JierunCHEN/Implement-a-Photovoltaic-Power-Tracker-Prototype/README.md

# Implement-a-Photovoltaic-Power-Tracker-Prototype
This is a project selected from the Electronic Product Design Contest in Jiangsu province in 2013. The repository includes both hardware and software guides. Make it and have fun!
