JierunCHEN/Implement-a-Photovoltaic-Power-Tracker-Prototype/hardware_docs/Soldering_Guide/物件清单.pdf

名称 | 型号规格 | 数量
Description | Comment | Quantity
模拟光伏追踪系统执 行机构（已安装） | 包括塑料实验箱，DCP-12-1,DCP-12-2,DCP-12-3，塑料支架等 | 1
铝围机箱 | 260*150*290 | 1
前面板（酚荃板） | DCP-12 | 1
后面板（酚荃板） | DCP-12-2 | 1
底板（酚荃板） | DCP-12-3 | 1
船形开关 | | 1
七芯航空插座（圆） | XS12P | 1
四芯航空插座（圆） | XS12J4A | 1
接线端子（座） | SH242-5.08-4P | 1
接线端子（头） | SH241-5.08-2P | 2
接线端子（座） | SH242-5.08-2P | 2
彩色杜邦线（两头孔） 50cm | | 4
二号导线 | 100CM 红 | 8
二号导线 | 30CM 黑 | 8
二号导线 | 100CM 绿 | 2
二号导线 | 50CM 蓝 | 6
12P扁平带连接线 | 50cm | 7
船形开关插簧 | φ4.8 | 4
船形开关插簧套 | | 4
铜柱子 | M5x10+M3 | 5
铜柱子 | M5x35+M3 | 10
自攻螺丝 | 带垫M3x8 | 5
沉头螺丝 | M3x8 | 5
十字螺丝 | M3x12 | 15
面板螺丝 | M3x6 | 15
螺母 | M3 | 20
平垫 | M3 | 20
弹垫 | M3 | 20
线号号码管 | +12V | 15
线号号码管 | GND | 15
线号号码管 | V1 | 3
线号号码管 | V2 | 3

线号号码管 | V3 | 3
线号号码管 | V4 | 3
线号号码管 | V5 | 3
线号号码管 | OUT1 | 3
线号号码管 | OUT2 | 3
线号号码管 | MOTOR+ | 3
线号号码管 | MOTOR- | 3
热缩管 | φ4 | 40CM
绑扎带 | | 20
黄腊管 | φ2.5 | 50CM
连接线1（已做好） | 4P接线端子*2+80CM线 | 1
连接线2（已做好） | 七芯头+80CM线+6P接线头 1
连接线3（已做好） | 四芯头+80CM线+4P接线头 1
模拟太阳能板焊接套件另见设计元器件清单 | | 1
H桥PWM输出电路焊接套件另见DCP-218-A元器件清单 1
