JierunCHEN/Implement-a-Photovoltaic-Power-Tracker-Prototype/hardware_docs/Soldering_Guide/设计元器件清单.pdf

名称 | 型号规格 | 封装 | 数量
Description | Comment | Footprint Quantity
线路板 | DCP-12-4 V1.0.PCB | | 1
单圈电位器 | WH5-1A 2.2K | | 1
单圈电位器 | WH5-1A 1K | | 1
单圈电位器 | WH5-1A 470 | | 1
3296可调电位器2K | | 3296W | 1
3296可调电位器5K | | 3296W | 2
3296可调电位器200欧姆 | | 3296W | 1
贴片电容 | 0.1uF | 0805C | 2
贴片电容 | 0.01uF | 0805R | 2
贴片电阻 | 200欧姆 | 0805R | 5
贴片电阻 | 330欧姆 | 0805R | 5
贴片电阻 | 510欧姆 | 0805R | 5
贴片电阻 | 1K | 0805R | 5
贴片电阻 | 2K | 0805R | 5
贴片电阻 | 3.3K | 0805R | 5
贴片电阻 | 5.1K | 0805R | 5
贴片电阻 | 10K | 0805R | 5
贴片电阻 | 12K | 0805R | 5
贴片电阻 | 15K | 0805R | 5
贴片电阻 | 18K | 0805R | 5
贴片电阻 | 20K | 0805R | 5
贴片电阻 | 22K | 0805R | 5
贴片电阻 | 27K | 0805R | 5
贴片电阻 | 0欧姆 | 0805R | 5
贴片芯片 | LM358 | SOIC8 | 1
接线插座（直） XH2.54-4P | | HDR1*4 | 1
