JierunCHEN/Implement-a-Photovoltaic-Power-Tracker-Prototype/(list of files, cad)

Other CAD files:
Debug/sor/Internal_ADC.obj
Debug/sor/ADS1118A.obj
Debug/sor/key_event.obj
Debug/sor/clock.obj
Debug/sor/Motor.obj
Debug/sor/cry12864.obj
