JierunCHEN/Implement-a-Photovoltaic-Power-Tracker-Prototype/project_log_JierunCHEN.txt

2016/7/16
1.	下载FTP上软件包，安装CCS5.1屡战屡败，于是尝试安装CCS5.4版本，同样安装未果，因为班上大部分人安装5.4版本都成功了，所以应该是我机子或电脑设置存在问题。
2.	寻求度娘帮助，尝试了几种办法，关闭杀毒软件，清理注册表重装，安装路径设为全英文，然而都没有效果。
3.	于是注册了Ti论坛账号寻求帮助，得到好心人指点，原因在于电脑账户名应改为英文
4.	我尝试在不建立新账户名的情况下安装软件，CCS软件可以用了，但其他程序出现问题了。于是只好乖乖建立一个新的英文账户，同时应注意workspace路径不能出现中文。

2016/7/17
1.	观看ccs使用教学视频，学会项目建立，源文件和头文件建立，编译和调试等基本操作。
2.	测试学习MSP4300G2553开发板和Lauchpad口袋实验平台例程。学会开发板上LED灯的亮灭和亮度控制，机械按键和触摸开关的使用。

2016/7/18
1:40pm-5:00pm	
1.	学习MSP430单片机的基础操作，如位操作、寄存器的配置方法、中断的使用等；
2.	测试学习MSP4300G2553开发板和Lauchpad口袋实验平台例程

2016/7/19
2：00pm-4:20PM   
翻看Lauchpad口袋实验平台学习资料中的系统时钟、GPIO和TIMEER_A定时器三部分。
7：30pm-11：00pm 
对应实物查看光伏发电跟踪器各模块原理图，和队友探讨分析各部分作用和工作原理。

2016/7/20
8：40am-11：50am
编写光伏发电跟踪器的结构原理解析文档，对整个系统的功能、结构和原理进行综述，再对各模块进行分解剖析。
7：00pm-8：00pm 
检查光伏发电跟踪器硬件是否完好，除接线断裂之外，其他模块可以正常使用。
9：00pm-11：00pm
查看MSP430F5438A定时器设置和PWM波生成方法，掌握定时器初始化函数、周期设定函数和占空比设定函数，确定适合本项目的模式，如增计数模式，OUTMODE为模式7。

2016/7/21
1.	编写PWM波生成文件，观察电机转速及方向，找到合适的周期和占空比。
2.	查看MSP430F5438A使用手册中的内置ADC模块，明白各个控制寄存器和存储寄存器的使用方法，并选择合适的模式（看了十多页的英文文档感觉自己的英语水平提高了呢）。
3.	尝试使用Grace方法编写ADC模块文件，可惜最终悲伤地发现MSP430F5438A不支持Grace插件。

2016/7/22
9：40am-10：30pm
1.	选择MSP430内置12位ADC转换模块编写程序，对照MSP430使用手册，逐一确定ADC控制寄存器的状态，例如设置采样源、设置采样保持时间、选择参考电压源、设置采样顺序及节点、选择多通道单步模式等，最终编完的程序虽然仅有十几行，但却费了我好几个小时。
2.	查看ASD1118用户手册，根据例程改造AD转换程序，选择双通道差模模式。
3.	调节光电检测模块的四个电位器，校准V1、V2和V4、V5电压。
4.	将电机驱动程序和光电检测程序配合，查看效果，能实现正反转，但位置存在一定偏差，初步原因是电机的惯性作用，初步解决方法是变速控制电机。

2016/7/23
1.	搭建总程序框架，完成模式选择、按键设置、采样值转化、启动和停止功能，尚未调试。
2.	还差0.1s定时中断编写。

2016/7/24
11：00am-10：20pm
1.	编写100ms定时中断程序，完成发电模式和跟踪模式的计时，同时每中断一次，更新显示屏上的发电功率和发电量。
2.	编译程序，消除出现的简单错误，如变量重复定义，中英文字符错用。
3.	调试程序，发现出现三个bug，倒计时出现乱码，发电模式下多显示了跟踪模式几个字，发电功率和发电量出现错误。
4.	dedug后发现，上述三bug的原因分别是是倒计时中记录时间的标志位被提前更改，跟踪模式写入地址有误且需要在切换模式时清屏，将发电功率逐位显示有误。
5.	继续调试打怪，发现发电总量一旦超过10000WS,程序就跑飞，原因是此时程序中给一个16位int局部变量beishu赋值100000，该变量溢出。
6.	在相继解决了其他大大小小的问题后，最终开环下系统运行正常，尚未发现其他问题。
7.	初步规划PID控制方法，根据临界比例度法更改程序（在备份开环系统程序后），开辟一个足够大的数组用于存储光电检测数据（数组长度过大程序会跑飞）。
8.	焊接光电检测模块断掉的线。

2016/7/25
8：40am-01：20pm
1.	编写程序，以0.1s为间隔记录开环控制下被控变量光伏检测通道差值ΔU，导出数据并绘制成曲线图，根据临界振荡方法确定PID控制的参数。
2.	根据临界振荡方法确定的PID控制方程更改程序，再次以0.1s为间隔记录开环控制下被控变量光伏检测通道差值ΔU，导出数据绘制曲线图，结合肉眼观察并分析曲线发现，此时虽然电机振荡衰减速度很快，但首次振荡过调幅度很大，综合考虑后决定去除积分环节。
3.	去除积分环节后，发现电机转动过调幅度明显减小，但速度过慢，于是我们结合电机全速运转和PD调节，让电机最初速度加快，当被控变量接近目标值再加入PD调节。
在电机速度既快、过调量也较小的情况下，反复调节比例系数、微分系数、PD控制阀门和光伏检测通道差值ΔU误差容限，使得控制电机不出现振荡或振荡幅度很小且衰减速度很快。
