JierunCHEN/Implement-a-Photovoltaic-Power-Tracker-Prototype/hardware_docs/Soldering_Guide/DCP-218-A H桥PWM输出电路 .pdf

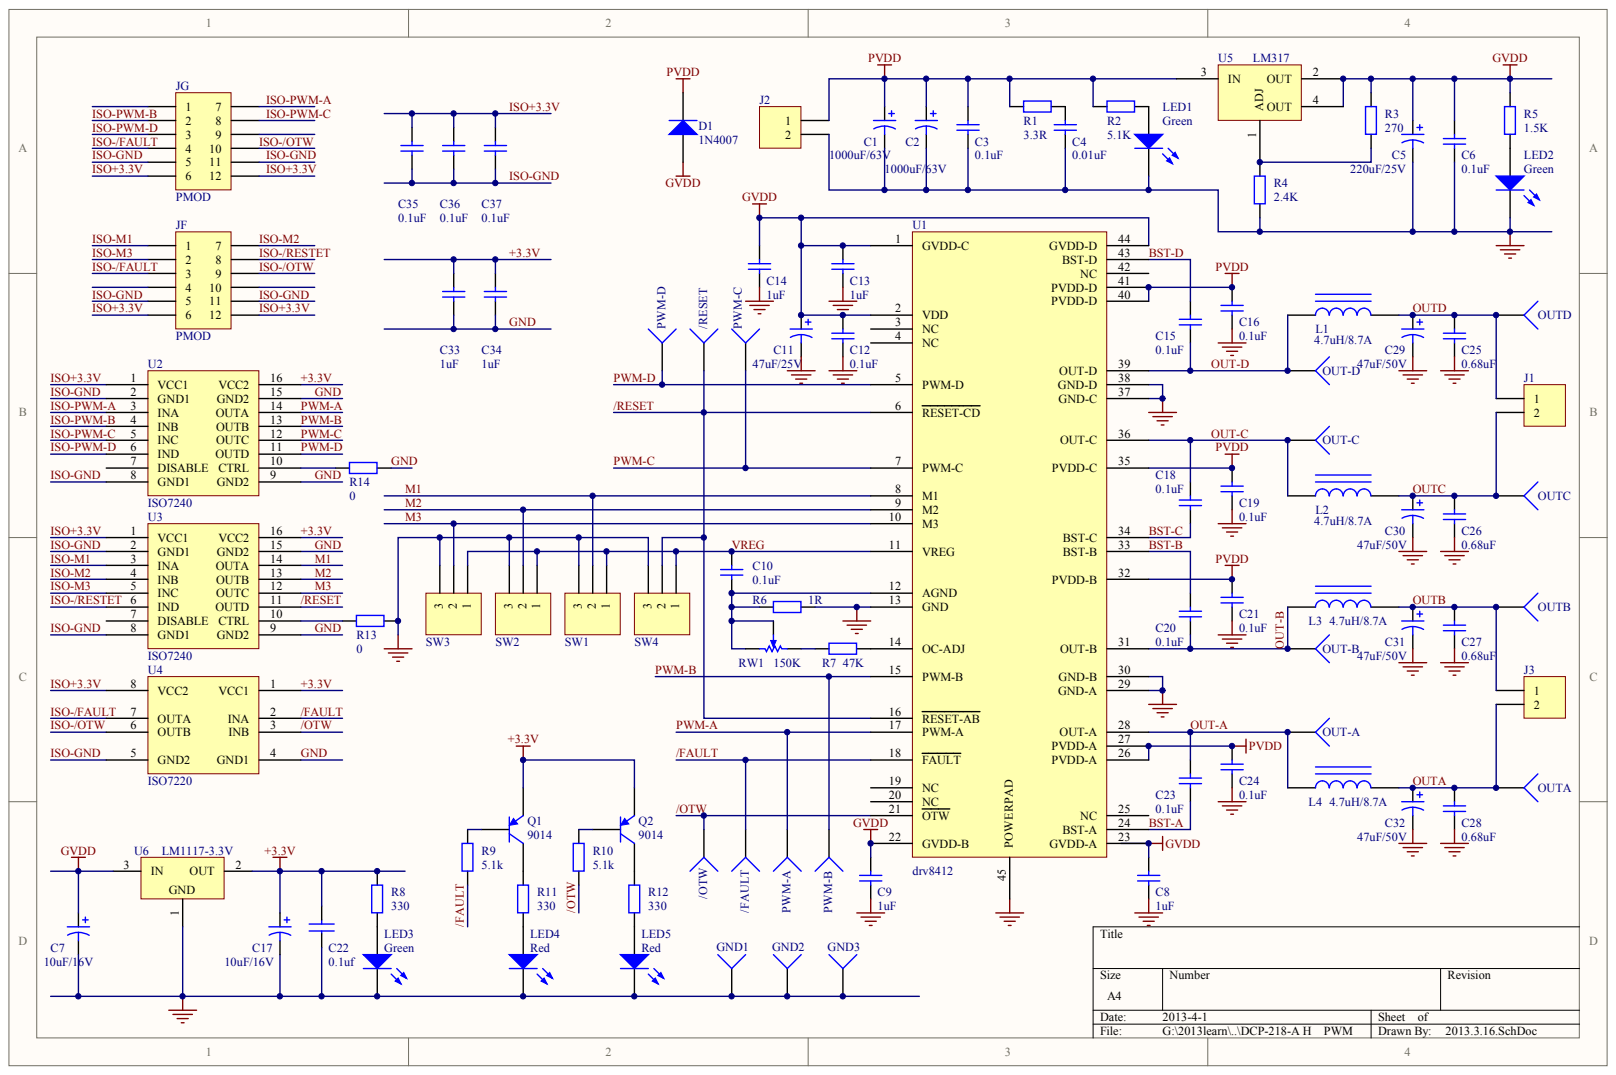
[picture p20: page 1]

AGND 12
GND 13
