JierunCHEN/Implement-a-Photovoltaic-Power-Tracker-Prototype/hardware_docs/Soldering_Guide/模拟光伏追踪系统图.pdf

## 2013年4月20日

# 模拟光伏追踪系统

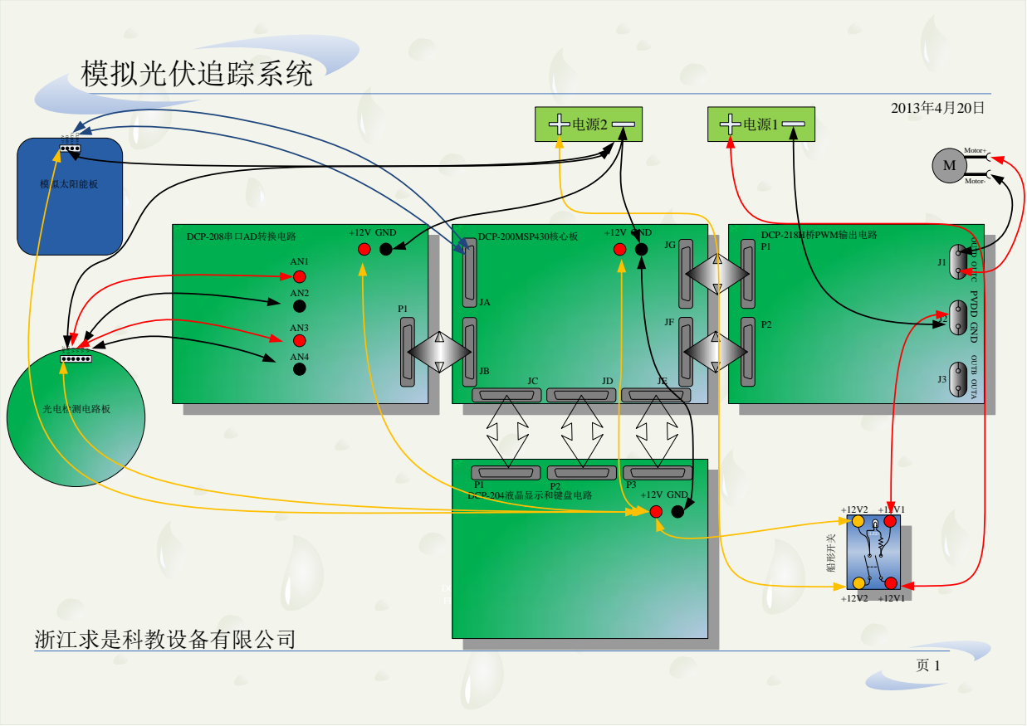
[picture p21: page 1]
D OUTC OUTD; DCP-200MSP430核心板; DCP-101-LX9 FPGA核心板; M Motor+; Motor-; 浙江求是科教设备有限公司; 模拟太阳能板; 光电检测电路板; DCP-208串口AD转换电路; DCP-218H桥PWM输出电路; OUTA OUTB; +12V GND; VCC GND; V5 +12V GND VOUT1 VOUT2; DCP-204液晶显示和键盘电路; LED +12V2 +12V1
