JierunCHEN/Implement-a-Photovoltaic-Power-Tracker-Prototype/hardware_docs/Soldering_Guide/DCP-12-2光电检测电路原理及接线图.pdf

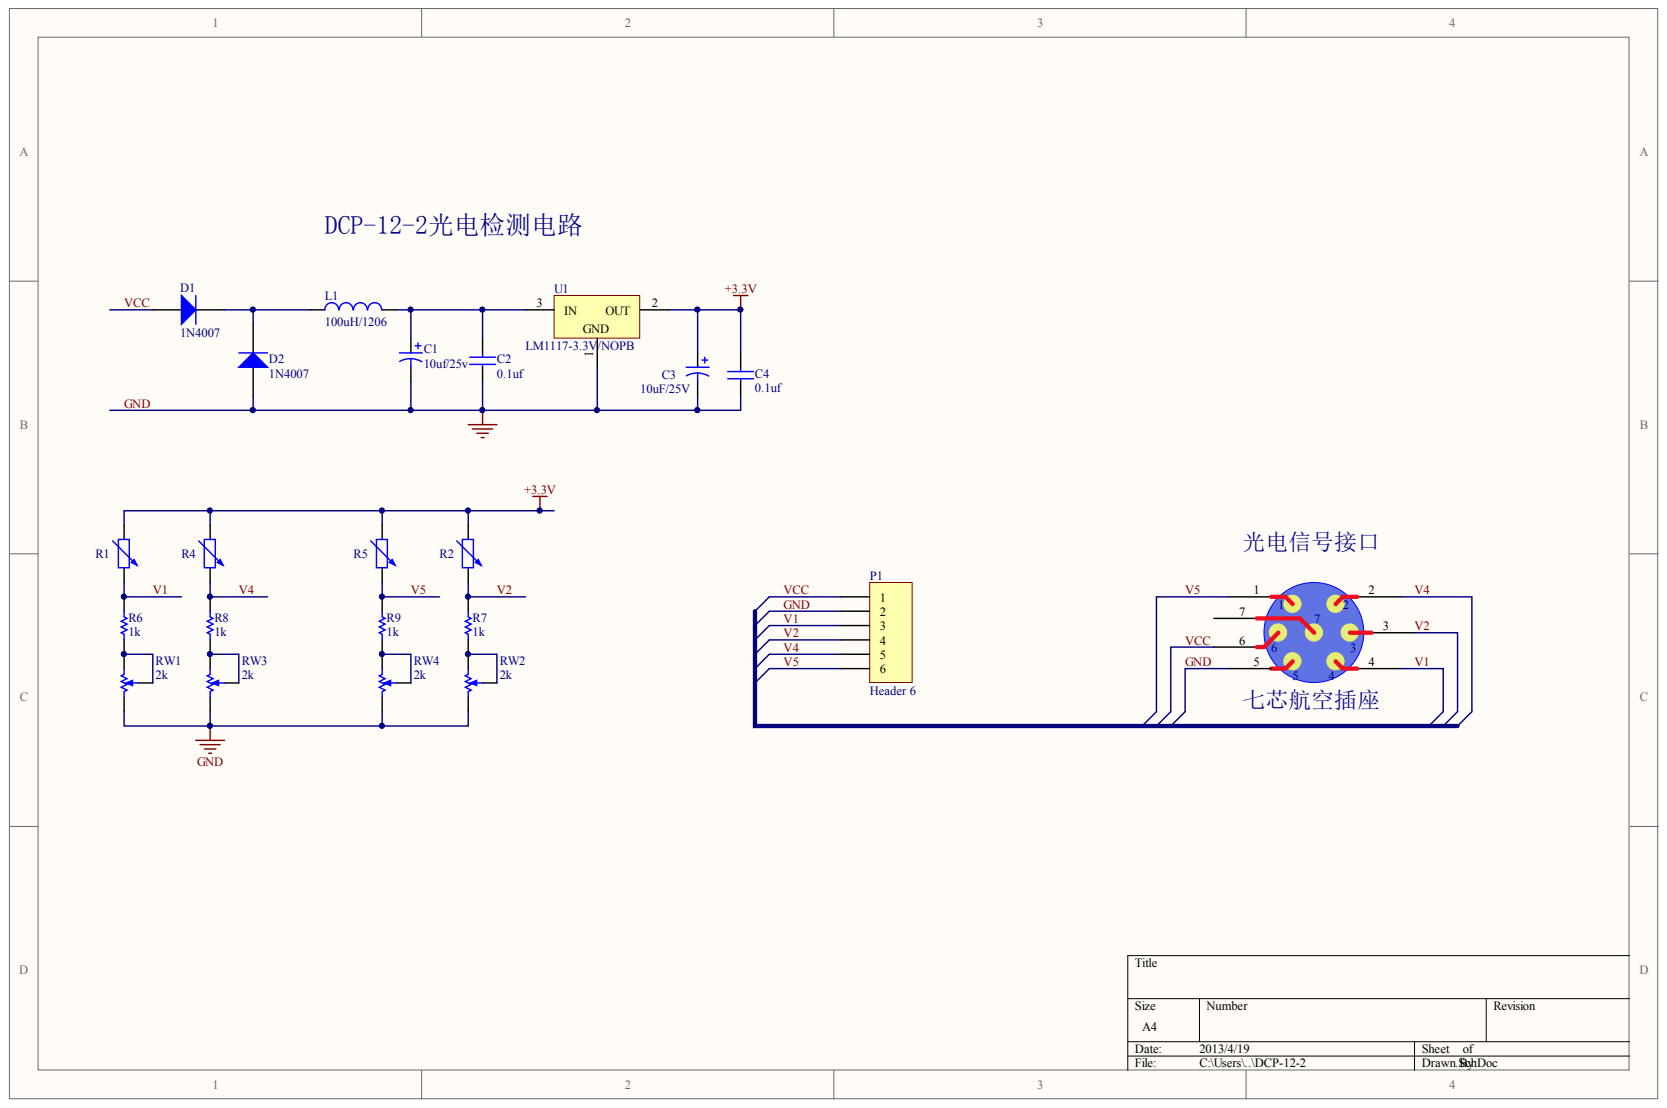
[picture p22: page 1]
