JierunCHEN/Implement-a-Photovoltaic-Power-Tracker-Prototype/hardware_docs/Soldering_Guide/DCP-12-4模拟太阳能板原理及接线图.pdf

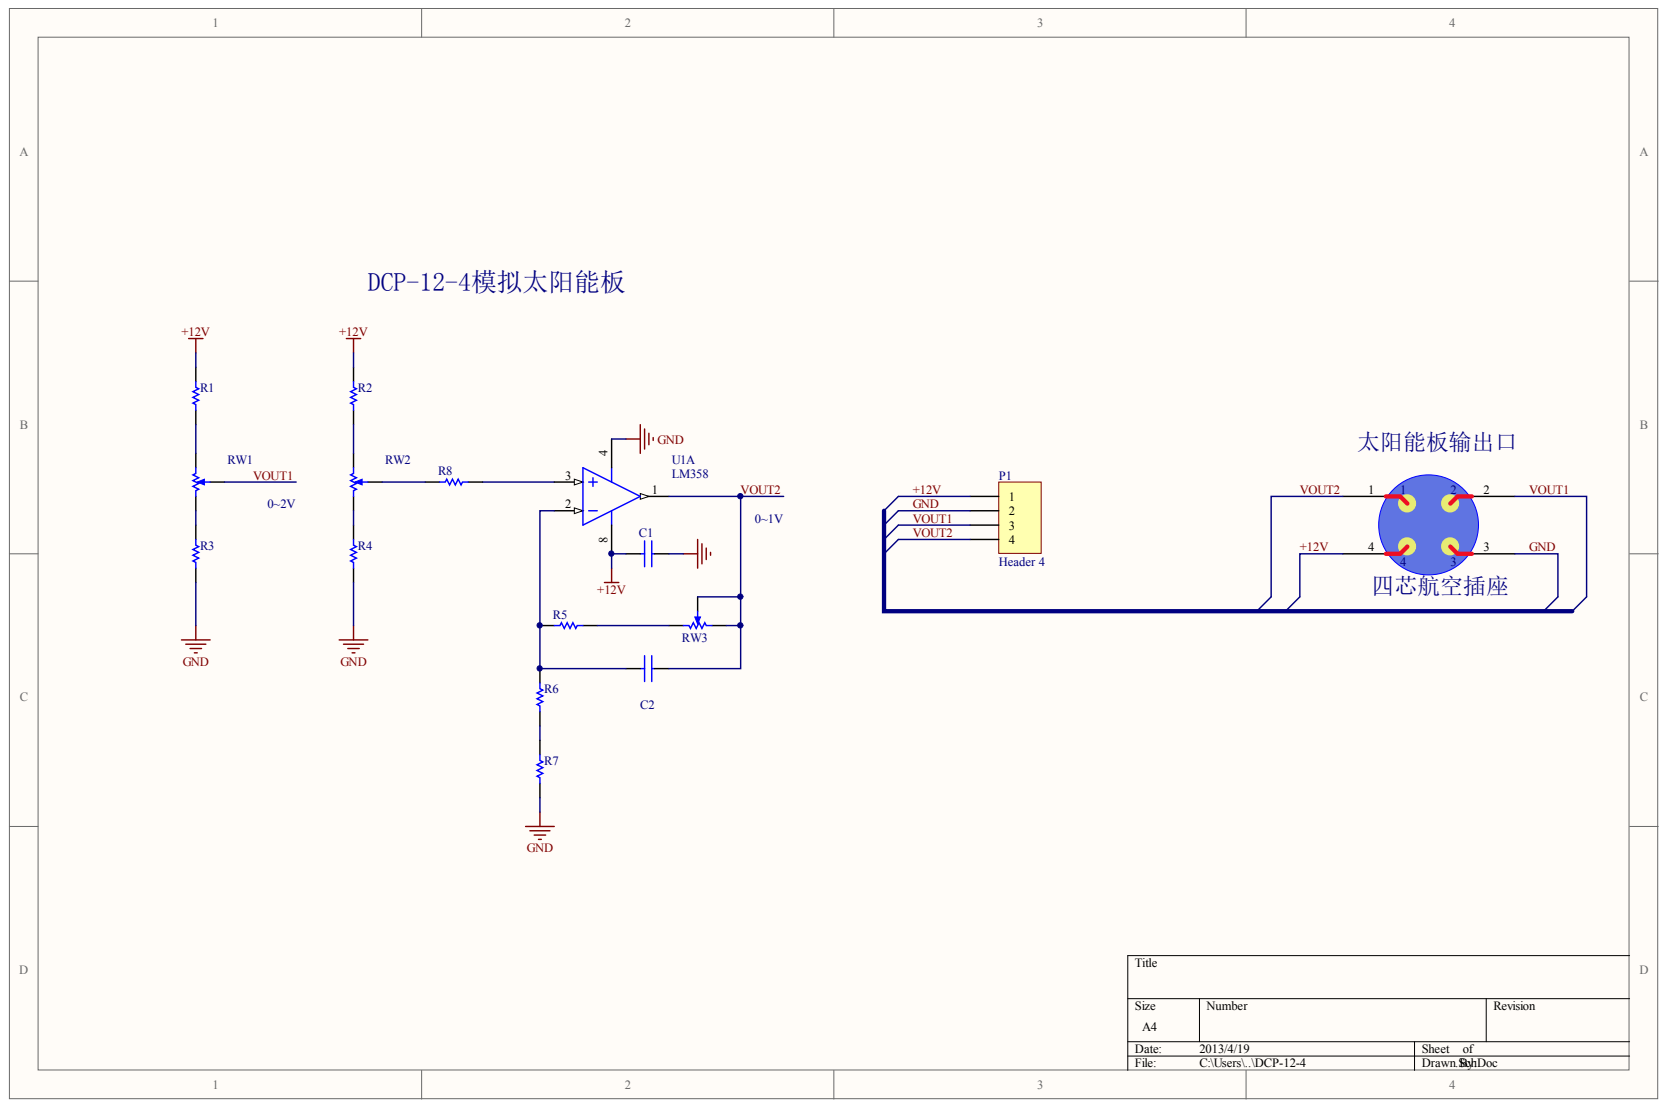
[picture p23: page 1]
