JierunCHEN/Implement-a-Photovoltaic-Power-Tracker-Prototype/hardware_docs/Soldering_Guide/DCP-200-A 核心板.pdf

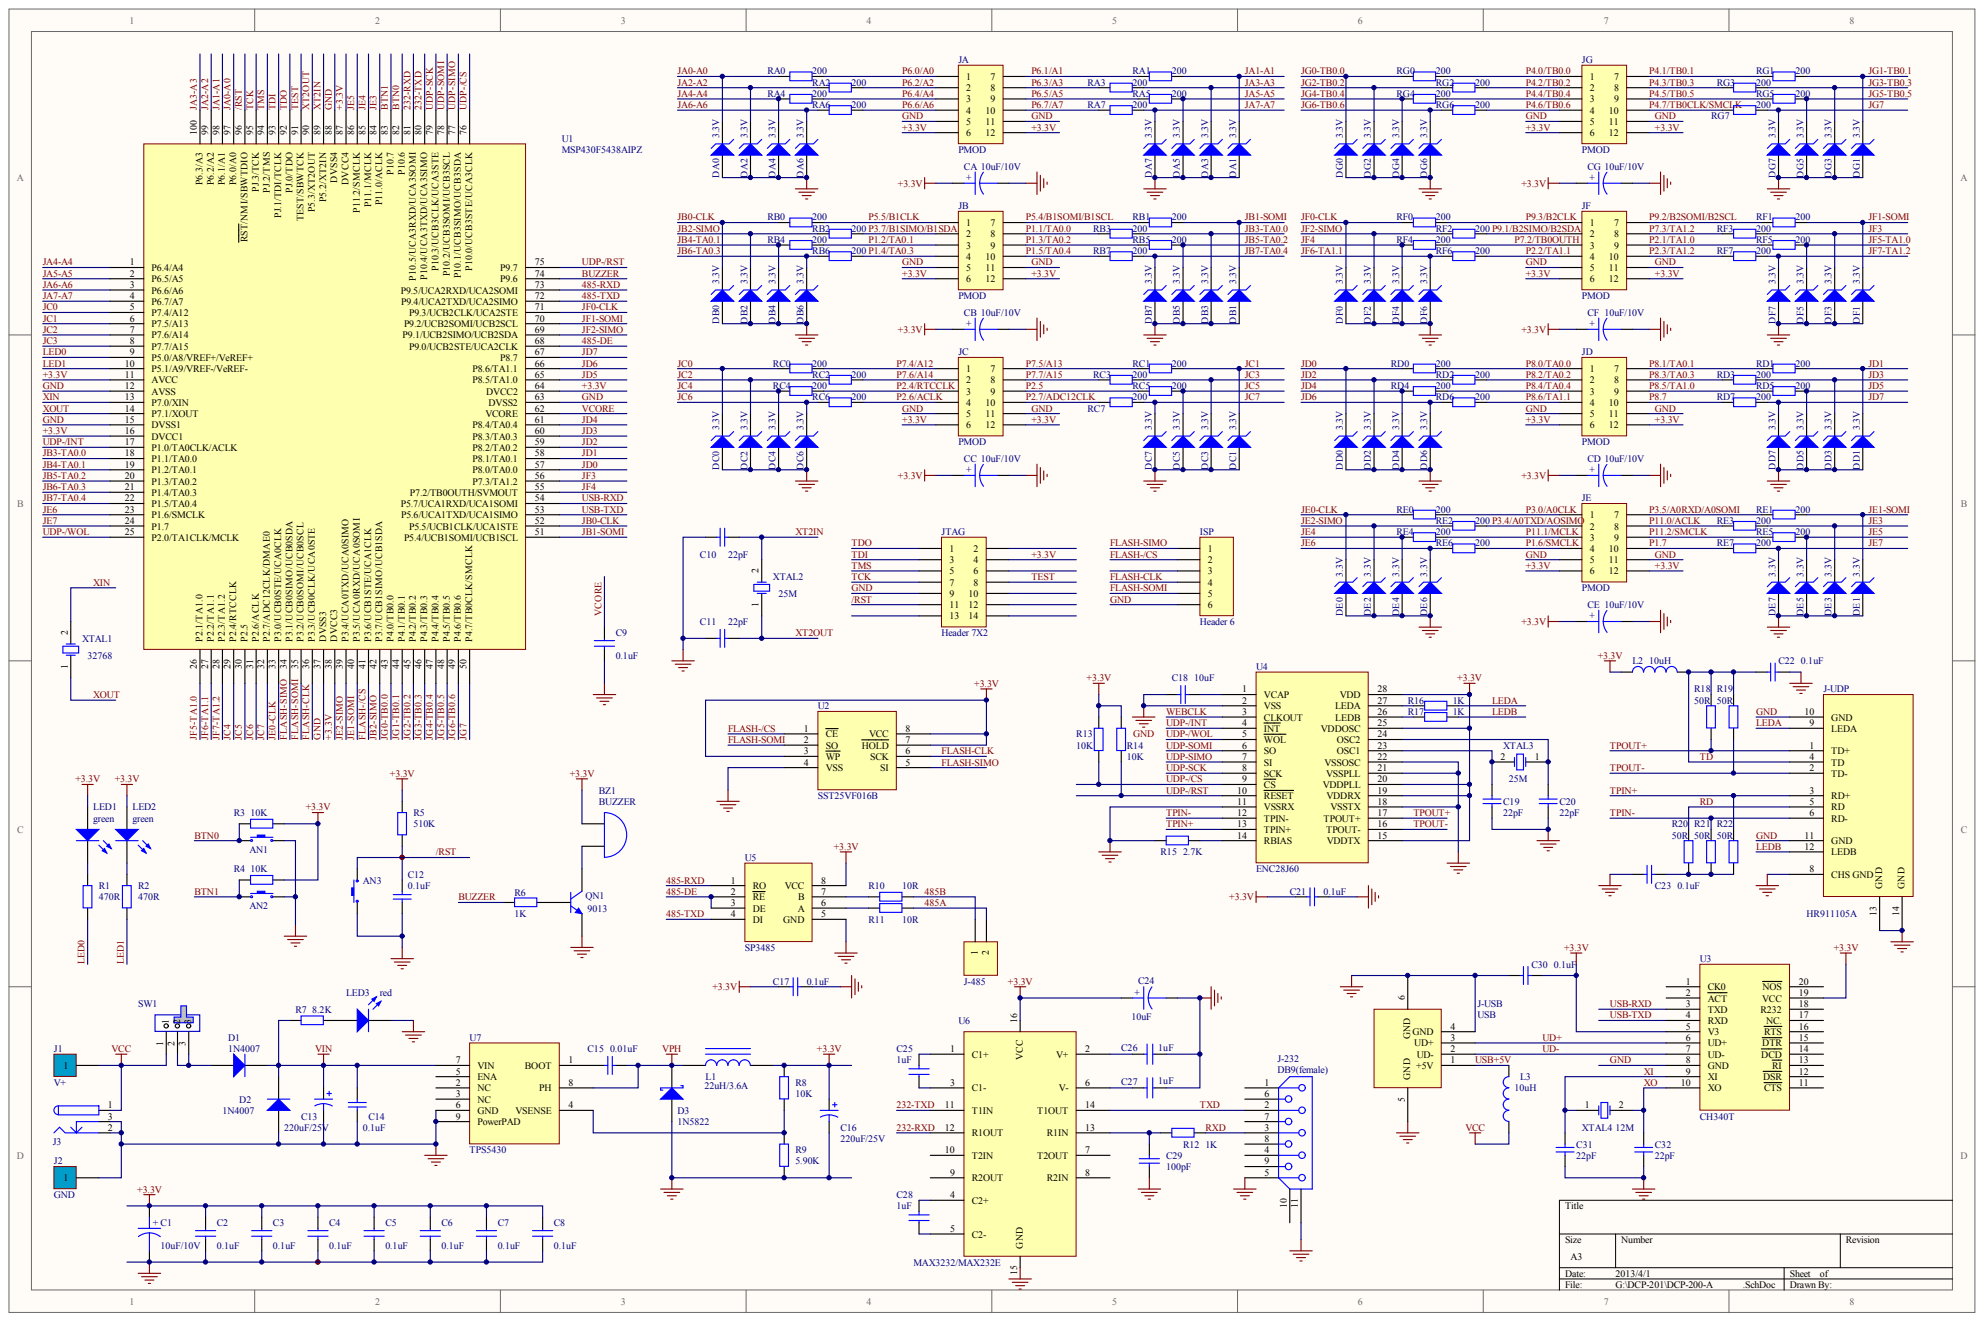
[picture p24: page 1]
