JierunCHEN/Implement-a-Photovoltaic-Power-Tracker-Prototype/hardware_docs/Soldering_Guide/DCP-204 液晶显示和键盘电路.pdf

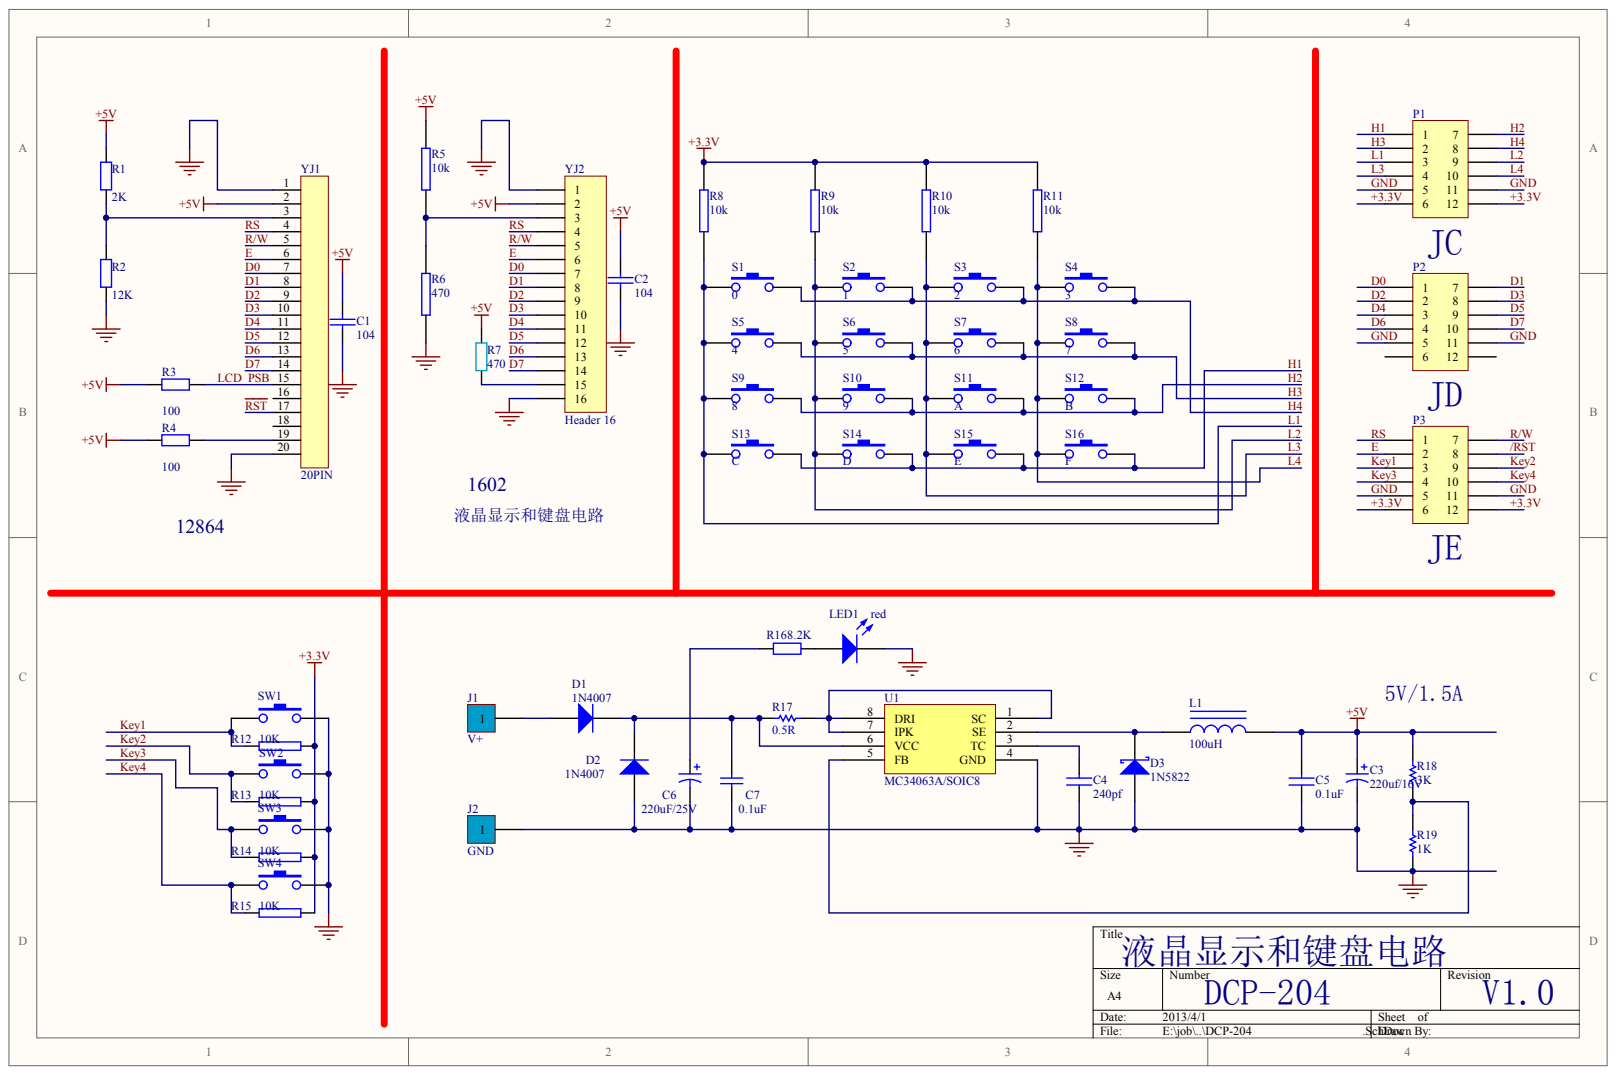
[picture p25: page 1]

9 | | A | B | H4
S14 | | S15 | L1 S16 L2 L3
