JierunCHEN/Implement-a-Photovoltaic-Power-Tracker-Prototype/hardware_docs/Soldering_Guide/DCP-208-A 串口AD转换电路（ADS1118）.pdf

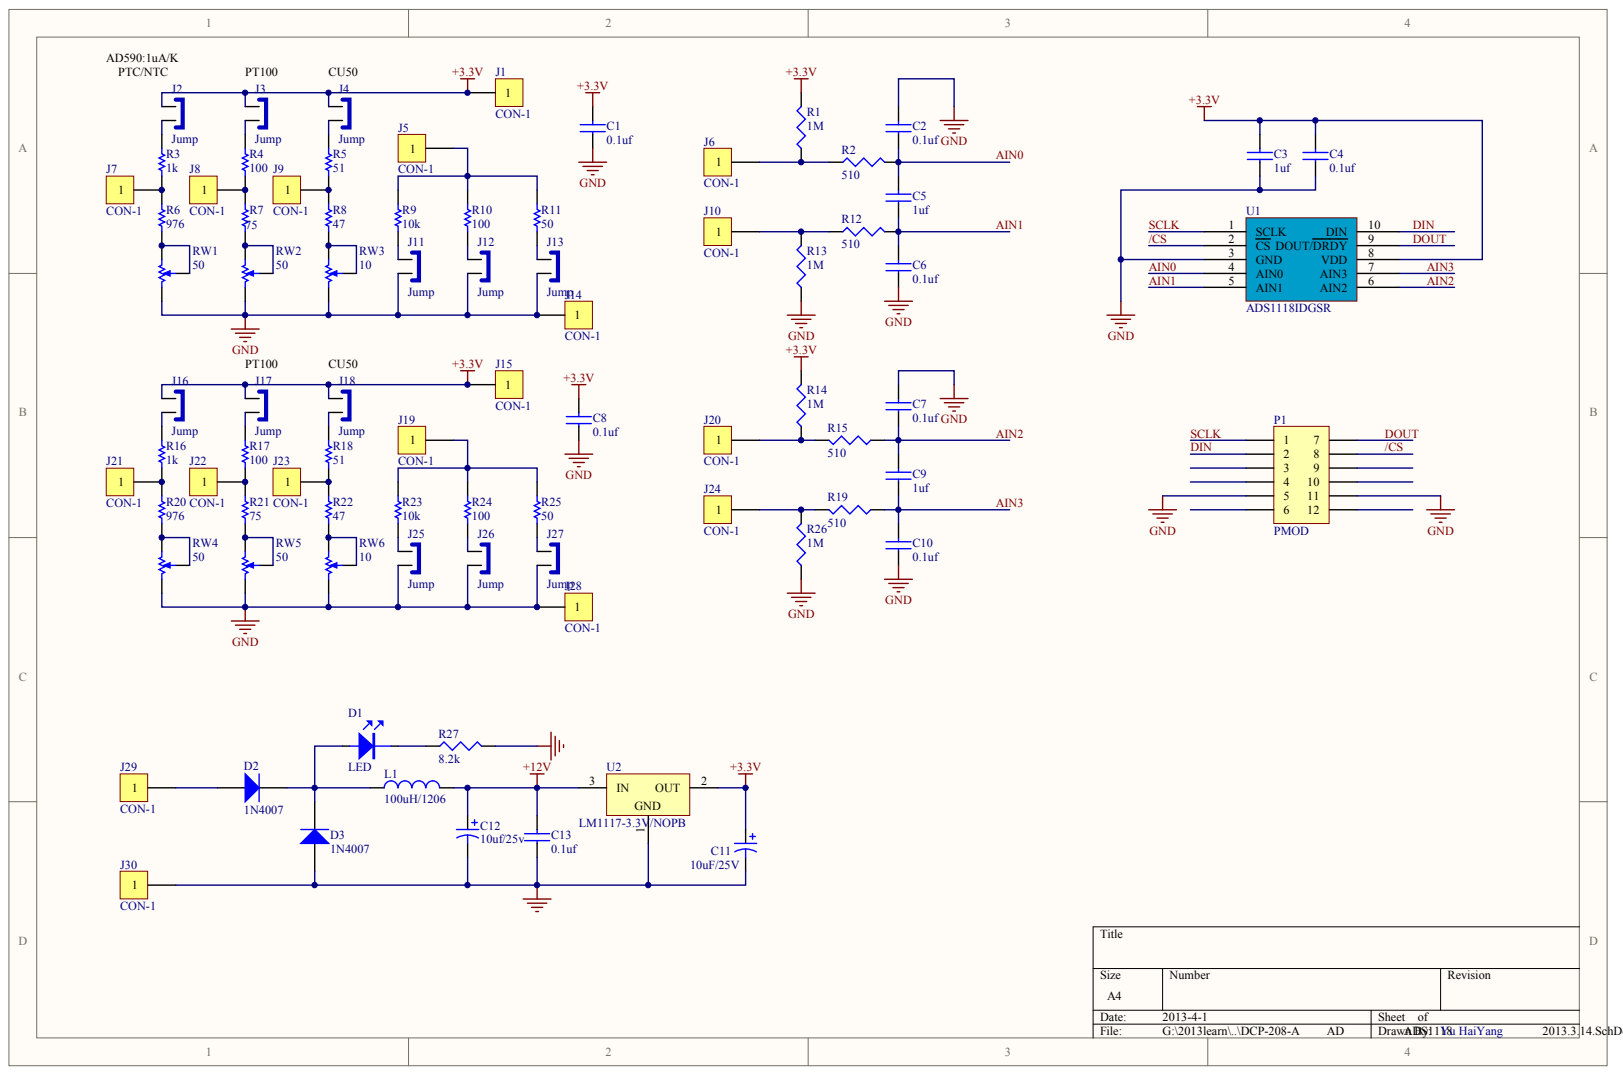
[picture p26: page 1]

SCLK DIN DOUT/DRDY

AIN0 AIN3 AIN1 AIN2
