JierunCHEN/Implement-a-Photovoltaic-Power-Tracker-Prototype/(list of files, drawings)

Other design files:
hardware_docs/PCB_Design/PCB_src（Altium designer）/模拟光伏追踪系统原理图.SchDoc
hardware_docs/PCB_Design/PCB_src（Altium designer）/模拟光伏追踪系统封装库.PcbLib
hardware_docs/PCB_Design/PCB_src（Altium designer）/模拟光伏追踪系统约束条件线路板.PcbDoc
hardware_docs/PCB_Design/PCB_src（Protel99）/模拟光伏追踪系统约束条件线路板.pcb
