JierunCHEN/Implement-a-Photovoltaic-Power-Tracker-Prototype/src/ADS1118A.h

/*
 * ADS1118A.h
 *
 *  Created on: 2016-7-22
 *      Author: JierunChan
 */

#ifndef ADS1118A_H_
#define ADS1118A_H_

extern float ADS1118A_Act();
extern void ADS1118A_Init();

#endif /* ADS1118A_H_ */
