JierunCHEN/Implement-a-Photovoltaic-Power-Tracker-Prototype/src/key_event.h

/*
 * key_event.h
 *
 *  Created on: 2016-7-23
 *      Author: JierunChan
 */

#ifndef KEY_EVENT_H_
#define KEY_EVENT_H_

extern unsigned int  key_event(void);
extern void key_change(void);

#endif /* KEY_EVENT_H_ */
